HoiHman/Simfeeback-STL-feet/Software.md

***
> **WICHTIG / IMPORTANT**  
Since we have no centering through search and get alarms its necessary that the actuators are complete down.
Step on every corner and then they will roll down if you are not sure if they are.
***

## Getting started / Setup

### **_Tactile/Shaker_**
* Setup the Soundcard were the shaker is attached. At the moment we support only one. 
* Press play and move the sliders, you will hear/notice if you have chosen the right one.
* Mount it under your seat or direct to the seat or whereever you think it suits your needs :)

Setup Shaker

### **_Flashing the Arduino_**
1. First you have to flash a supplied Hex file to the Arduino which can communicate with the software 
2. Choose correct com port and click Firmware
3. Browse to the hex file which you want flash (for example ACServo_Leonardo_00_08_02.hex in the Firmware Folder) and press upload

Flashing Arduino

### **_Choose the com port for your Arduino_**
ComPort

***

## Profiles Tab

### **_START/ STOP Button_**

If you have read and finished the setup things you should be able to startup the actuators. Press the START button and they will go to center position if everything is good :) 

The START button changes to STOP. Wait some seconds and press stop, the actuators should go to the park position. This should be really soft for the last mm :) If this works you should be ready to go.

Activate your profile (right mouse click) and press the start button. Start your game,go on track and it should move

## Profiles
* Every supported game can have one or more profiles which define how the Actuators should move. 
* You can have a profile for every Car/Road combination which you like.
* Right click and you can copy an existing one, delete or activate it.
* Left Click on it and you can rename it 

Start

***

## Effects
We created some Profiles with the most common effects for the easy start to your motion experience.
* **1 - Intensity**: increase / decrease the intensity of all the incoming gamedata, results in more or less motion
* **2 - Smoothing**: increase / decrease the smoothness of all the incoming gamedata, results in smoother or rougher motion
* **3 - Enabled**: Enables /disables the effect
* **4 - Smoothing**: increase / decrease the smoothness for the incoming gamedata of that effect, results in smoother or rougher motion
* **5 - Intensity**: increase / decrease the intensity for the incoming gamedata of that effect, results in more or less motion
* **6** - Reset intensity to 1

Effects

***

_**Tactile Effect**_ sends Data to a Shaker or buttkicker

_**Heave Effect**_ All four Actuators go synced up or down at the same time

_**Pitch Effect**_ The two actuators in front go down (up) and the 2 in the back go up (down). Used in Pitch and Surge.

_**Roll Effect**_ The two actuators on the left go down (up) and the 2 on the right go up (down). Used in Roll / Sway / Traction loss

_**Rumble(all)**_ Data like RPM will be available on all 4 actuators as vibrations 

***
_**Example Effect and description of Values**_ 

Heave
 
* **Linear** - if checked its a lot rougher :)
* **Name** - Name of the Effect (Heave)
* **Telemetry Key** - Choose the Key which will be used to create the Effect  (VertAccel)
* **Min Position** - Percentage used of the way the actuator can move (-100) / Heave uses ~22 Percent of the Actuator if the value -3 is reached    
* **Max Position** - Percentage used of the way the actuator can move (100) / Heave uses ~22 Percent of the Actuator if the value 3 is reached
* **Position Interval** - Interval which Position is divided (20)
* **Min. Power** - Range of values given by the simulation. Here 0 to -3g
* **Max. Power** - Range of values given by the simulation. Here 0 to 3g
* **Power Interval** - Interval which Position is divided (0,25)
* **Enabled** - if true -> then enabled 
* **Mute** - nevermind
* **Smoothing** - Value given by the smoothing Slider
* **Controller ID.** - Controller # used 
* **Intensity** - Value give by the Intesity Slider
