HoiHman/Simfeeback-STL-feet/STL-Files.md

[Here are the STL files of the actuator.](../tree/master/STL)
