HoiHman/Simfeeback-STL-feet/Shopping-List.md

A list of all parts required to build the SFX-100 Actuator.

_Our team is located in Germany, so most of the links point to German websites._
_If you are from another country and found a supplier in your country, please get in contact with us._

_Supplier and URL are only for better definition and are only examples_

| Item | Details | Quantity | Supplier | URL |
|---|---|---|---|---|
| aluminium profile _Systemprofil K50_ |  length: 250mm Teile Nr. H950N1010z | 4  |  Kinetik | <http://kinetikmsystem.de/profilsystem--konstruktionsprofile-K50-Nut-10/Aluminiumprofil-100x100--Konstruktionsprofil-K50--N10--100x100.html>  |
| thread insert  | Teile Nr. H92RH10M8  | 32  | Kinetik | http://kinetikmsystem.de/Aluprofil-Verbindungstechnik--profilverbindungstechnik--profilverbinder--montageverbinder--gelenke--schnellverbinder--klemmverbinder-/Reduzi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  |
| slot nut  | K45/K50 (N10)-M8, einschwenkbar | 16+ | Kinetik  |  http://kinetikmsystem.de/DIN--und-Normteile/Nutenstein-K45-K50--N10--M8--einschwenkbar.html |
| hollow shaft  | diameter = 30mm / length = 270mm / chamfer (both sides)  | 4  | Smalltec  | https://smalltec.de/de/wellenfuehrungen/praezisionswellen-fixlang/gehaertete-wellen/hohlwellen/Praezisions---Hohlwelle---30mm--C60-oder-100Cr6--Praezisionswelle----g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  |
| ball screw and nut  | type 1605 / length = 250mm | 4 | Modellbau-Letmathe | https://www.rc-letmathe.de/CNC-Mechanik/Kugelumlaufspindel-mit-Mutter-1605---verschiedene-Laengen |
| fixed bearing | type FK12 | 4 | Modellbau-Letmathe | https://www.rc-letmathe.de/CNC-Mechanik/Festlagereinheit-FK12 |
| linear bearing | type LMEK30UU | 4 | Dold | https://www.dold-mechatronik.de/Linearlager-mit-quadratischem-Flansch-30mm-LMEK30UU https://www.ebay.de/itm/162415651574 |
| shaft coupling | type 30L40 / size 10,0 - 16,0mm | 4 | Dold | https://www.dold-mechatronik.de/Wellenkupplung-XB-flexibel-D30L40-1000-1600mm |
| D-Sub cable | 25 pol / plug-plug | 4 | Reichelt | https://www.reichelt.de/d-sub-kabel-1-1-25-pol-stecker-stecker-1-8-m-2-0-m-ak-4010-p3997.html |
| D-Sub breakoutboard |  | 4 | Amazon | https://www.amazon.de/dp/B01N5CBPQE |
| Arduino Leonardo |  | 1 | Amazon  | https://www.amazon.de/dp/B008A36R2Y |
| cables | Arduino wiring | 1 | Amazon  | https://www.amazon.de/dp/B078RKZ745 |
| AC servo motor *| type 90ST-M02430 220V 750W | 4 | Aliexpress | https://de.aliexpress.com/store/product/90ST-M02430-220-v-750-watt-AC-Servo-motor-3000-rpm-2-4-N-M-0/3223052_32844070107.html |
| breadboard |  | 1 | Amazon | https://www.amazon.de/SODIAL-Steckbrett-Breadboard-Experimentierboard-Steckplatine/dp/B00JGFDKBQ |
| emergency stop |  | 1 | Amazon | https://www.amazon.de/dp/B06WVRV84B |
| O-ring | 23,5 x 30,5 x 3,5mm | 4 | Amazon | all four included in this set: https://www.amazon.de/gp/product/B000B9RKL2 |
| 3d-printing filament | type PLA | 3 | Amazon | https://www.amazon.de/gp/product/B071DM81ZK/ |
| floor protector | rubber feet | 4 | Amazon | all four included in this set: https://www.amazon.de/gp/product/B008MVVU4Y |

*Modbus RS-323/485 interface is an option. We do not support this at the moment, but if I would suggest to order this option for future proofness.

This is the 220v version, if you do have other voltages in your country,  please ask the seller.

## bolts and washers

| Type | Size | Quantity | used for | URL|
|---|---|---|---|---|
| DIN 912  | M8 x 40 | 32 | fixed / linear bearing mount |  https://www.wegertseder.com/ArticleDetails.aspx?AKNUM=2524 |
| | M6 x 85 | 16 | motor mount | |
|  | M6 x 25  | 16  | linear bearing  | |
|  | M4 x 25  | 16  | fixed bearing  | |
| DIN 6912 | M5 x 20 | 24 | slider | https://www.wegertseder.com/ArticleDetails.aspx?AKNUM=2560 |
| DIN 125  | A8,4 | 32 | fixed / linear bearing mount |  https://www.wegertseder.com/ArticleDetails.aspx?AKNUM=1490 |
| | A6,4 | 32 | linear bearing /motor mount | |
