HoiHman/Simfeeback-STL-feet/Sticky Foot Passive.stl

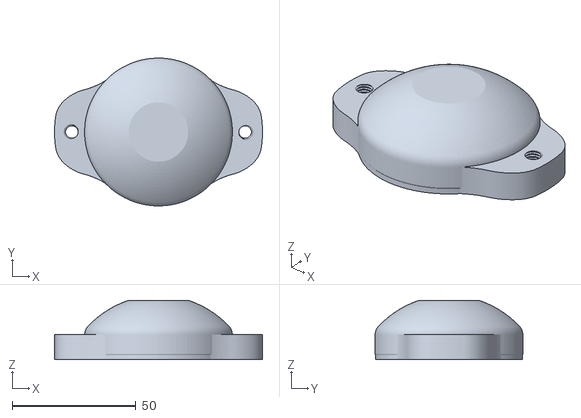
[picture p1: CAD file, 2019-06-02]
Sticky Foot Passive.stl
84.0 x 59.7 x 24.0
