HoiHman/Simfeeback-STL-feet/Sticking foot.stl

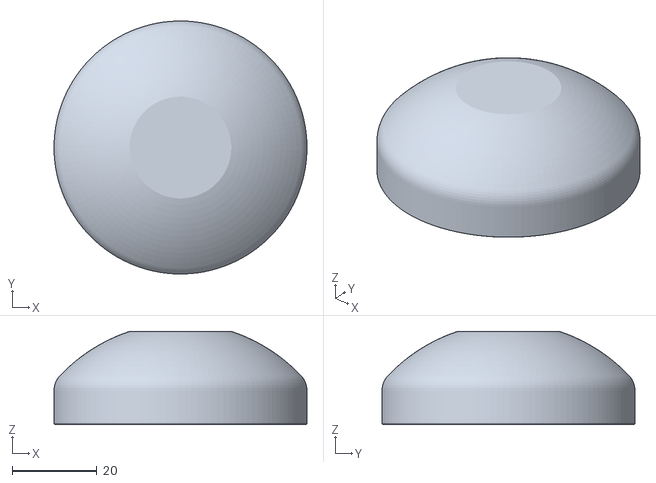
[picture p2: CAD file, 2018-09-23]
Sticking foot.stl
59.7 x 59.7 x 22.0
