HoiHman/Simfeeback-STL-feet/3D-Printing.md

## STL Files
* [Here are the STL files](./STL-Files)

## Slicer Settings
* We all used Simplify 3d to print our stuff. All the parts took about 2 weeks to print, so start with them while waiting for all the ordered parts.
* PLA was the chosen material, if you prefer PETG, go try it :)
* Use your already working / printing profile and change the following settings,this will make the prints rigid :)

Infill
Layer
