HoiHman/Simfeeback-STL-feet/(commit log)

2018-07-11 Created Actuator (markdown)
2018-07-14 Created AC Servo Settings (markdown)
2018-07-18 Created Electronics / Wiring (markdown)
2018-07-18 Updated Electronics Wiring (markdown)
2018-09-06 Updated AC Servo Settings (markdown)
2018-09-11 Created 3D Printing (markdown)
2018-09-11 Updated 3D Printing (markdown)
2018-09-12 Updated Electronics Wiring (markdown)
2018-09-12 Updated Actuator (markdown)
2018-09-12 Created STL Files (markdown)
2018-09-12 Updated STL Files (markdown)
2018-09-22 Modbus option + 220v
2019-06-02 Add files via upload
    Sticky foot with mounting holes for passive seat belt tensioner
    [Sticky Foot Passive.stl]
