HoiHman/Simfeeback-STL-feet/(notices)

Notices in the files:
Home.md:
CC BY-NC-SA 3.0
